Enggmaug/VentilationLignade/Carte Elec/VentilationLignade/VentilationLignade.kicad_pcb

## KiCad design Carte Elec/VentilationLignade/VentilationLignade.kicad_pcb (2017-06-05)

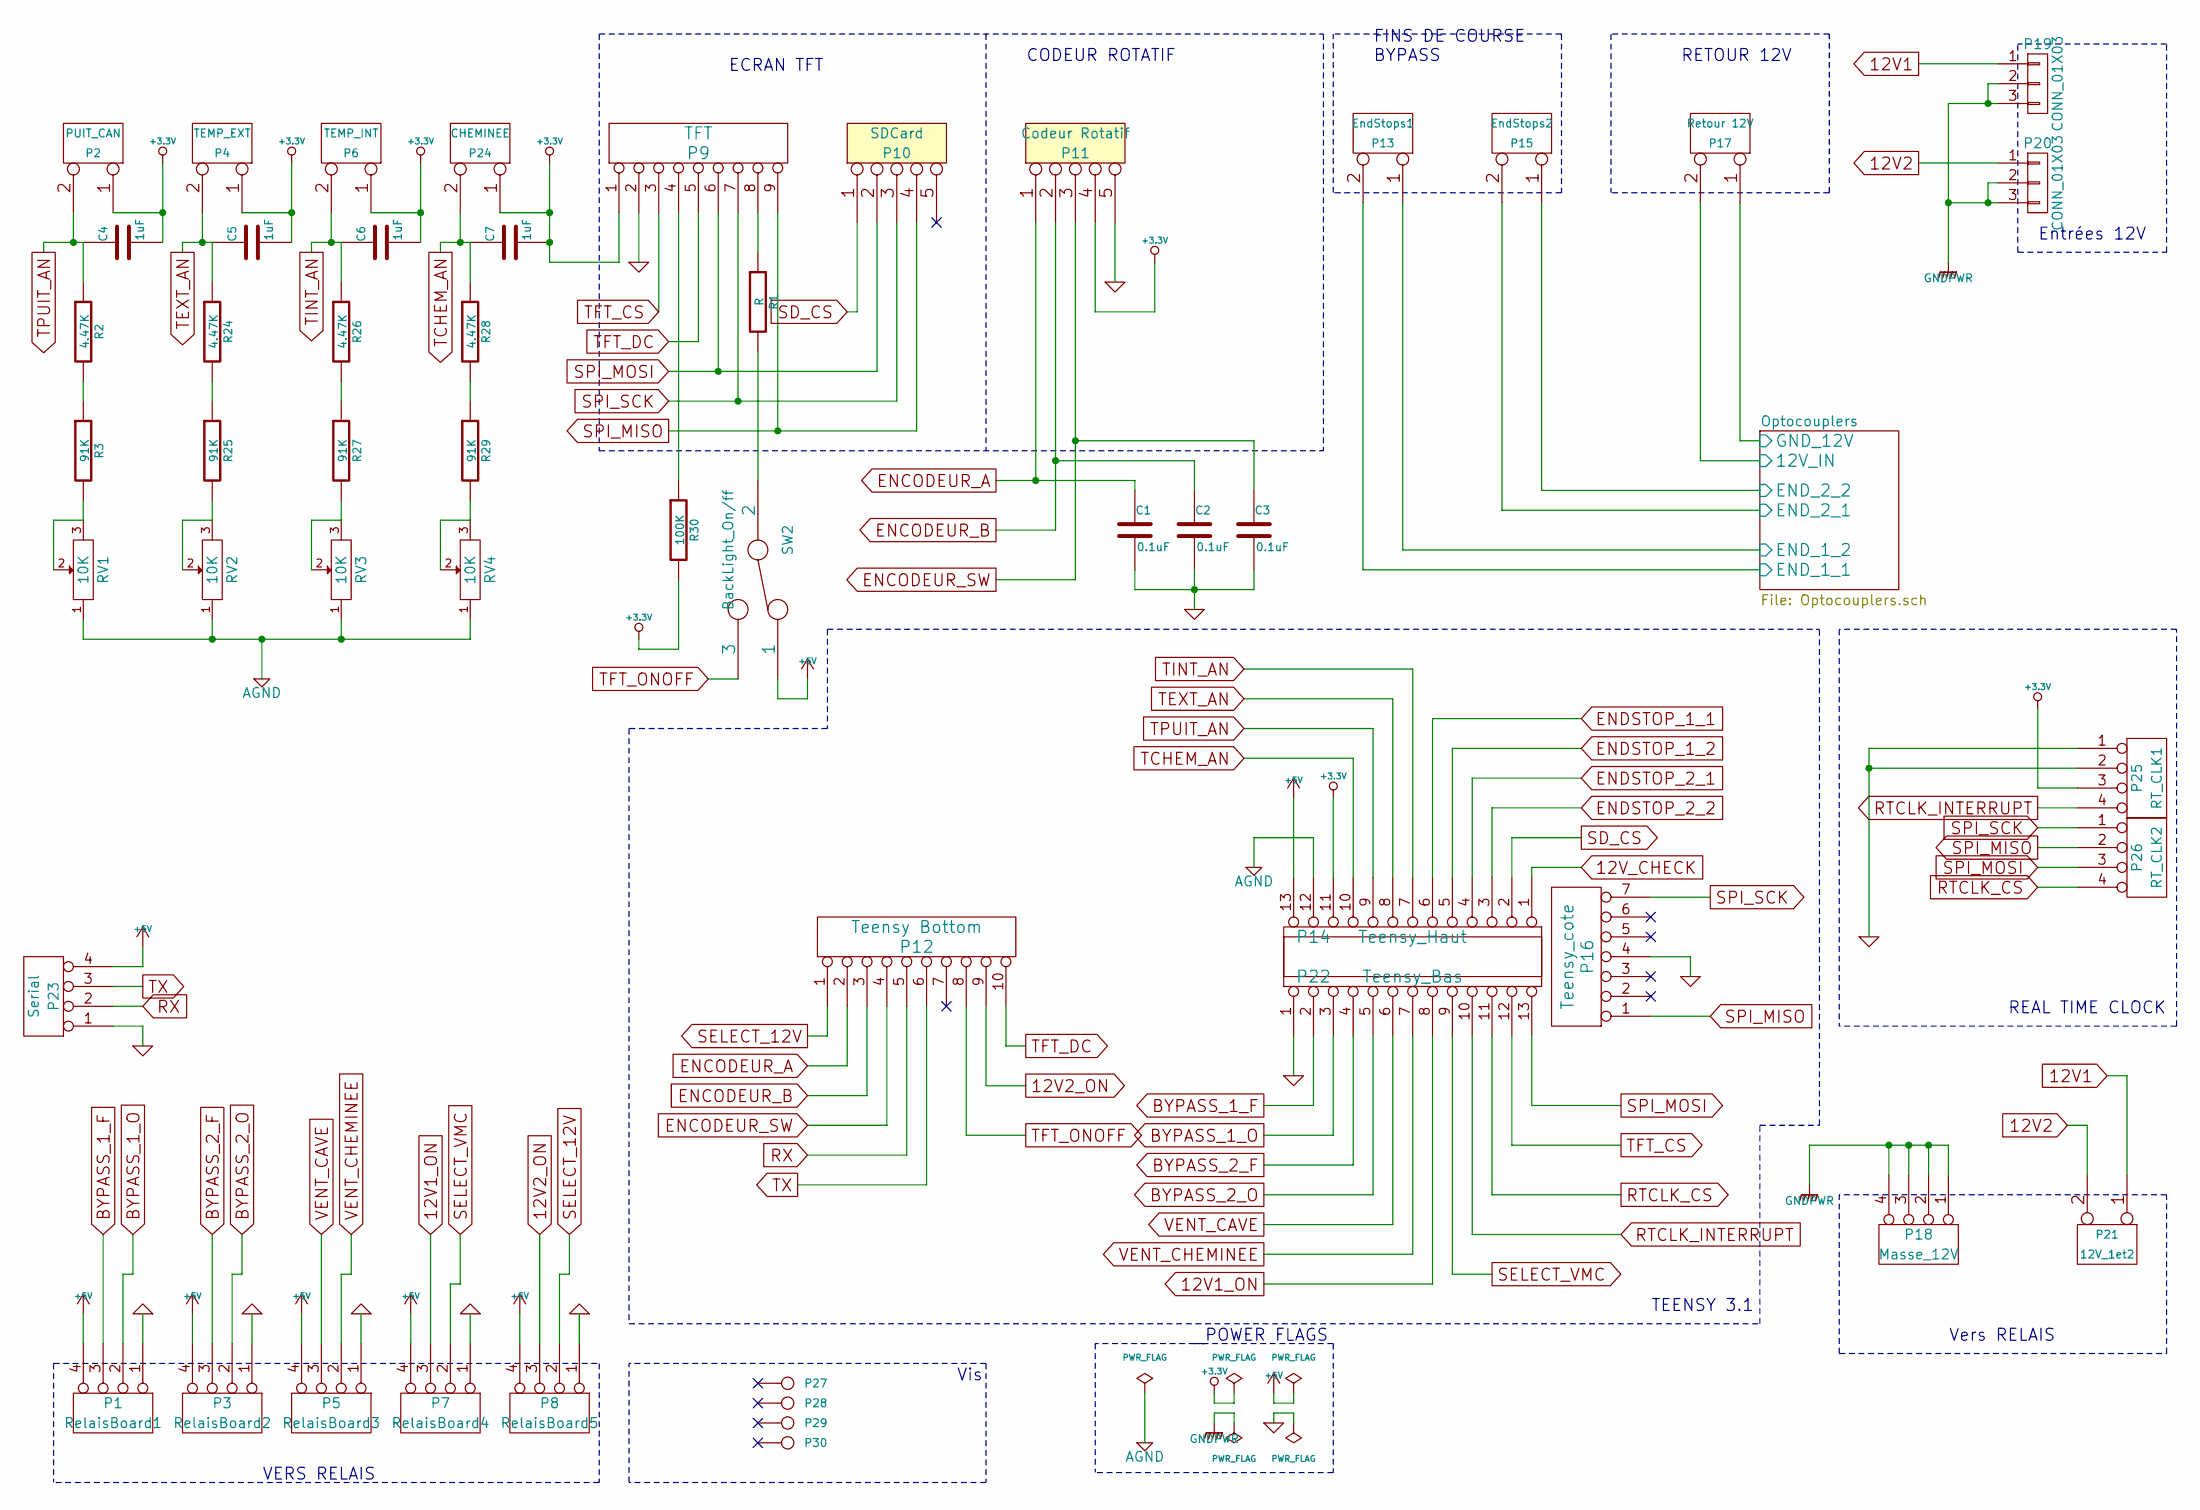
[picture p1: schematic VentilationLignade.sch]

Parts:
C1, C2, C3: 0.1uF; C_Rect_L7_W2.5_P5
C4, C5, C6, C7: 1uF; C_Radial_D8_L11.5_P3.5
P1: RelaisBoard1; Pin_Header_Straight_1x04
P2: PUIT_CAN; bornier2
P3: RelaisBoard2; Pin_Header_Straight_1x04
P4: TEMP_EXT; bornier2
P5: RelaisBoard3; Pin_Header_Straight_1x04
P6: TEMP_INT; bornier2
P7: RelaisBoard4; Pin_Header_Straight_1x04
P8: RelaisBoard5; Pin_Header_Straight_1x04
P9: TFT; Pin_Header_Straight_1x09
P10: SDCard; Pin_Header_Straight_1x05
P11: Codeur Rotatif; Pin_Header_Straight_1x05
P12: Teensy Bottom; Pin_Header_Straight_1x10
P13: EndStops1; bornier2
P14: Teensy_Haut; Pin_Header_Straight_1x13
P15: EndStops2; bornier2
P16: Teensy_cote; Pin_Header_Straight_1x07
P17: Retour 12V; bornier2
P18: Masse_12V; Pin_Header_Straight_1x04
P19, P20: CONN_01X03; Alim
P21: 12V_1et2; bornier2
P22: Teensy_Bas; Pin_Header_Straight_1x13
P23: Serial; Pin_Header_Straight_1x04
P24: CHEMINEE; bornier2
P25: RT_CLK1; Pin_Header_Straight_1x04
P26: RT_CLK2; Pin_Header_Straight_1x04
P27, P28, P29, P30: CONN_1; VIS
R1: R; Resistor_Horizontal_RM15mm
R2, R24, R26, R28: 4.47K; R_1206_HandSoldering
R3, R25, R27, R29: 91K; R_1206_HandSoldering
R30: 100K; R_1206_HandSoldering
RV1, RV2, RV3, RV4: 10K; Potar
SW2: BackLight_On/ff; Pin_Header_Straight_1x03

Connections:
12V1: P19.1, P21.1
12V1_ON: P7.3, P22.8
12V2: P20.1, P21.2 (PM)
12V2_ON: P8.3, P12.9
12V_CHECK: P14.1; also elsewhere on the board
+3.3V: C4.2, C5.2, C6.2, C7.2, P2.1, P4.1, P6.1, P9.1, P11.4, P14.11, P24.1, P25.3, R30.2; also elsewhere on the board
+5V: P1.4, P3.4, P5.4, P7.4, P8.4, P14.13, P23.4, SW2.1
/Optocouplers/12V_IN: P17.2 (PM); also elsewhere on the board
/Optocouplers/END_1_1: P13.2 (PM); also elsewhere on the board
/Optocouplers/END_1_2: P13.1; also elsewhere on the board
/Optocouplers/END_2_1: P15.2 (PM); also elsewhere on the board
/Optocouplers/END_2_2: P15.1; also elsewhere on the board
AGND: P14.12, RV1.1, RV2.1, RV3.1, RV4.1
BYPASS_1_F: P1.3, P22.2
BYPASS_1_O: P1.2, P22.3
BYPASS_2_F: P3.3, P22.4
BYPASS_2_O: P3.2, P22.5
ENCODEUR_A: C1.1, P11.1, P12.2
ENCODEUR_B: C2.1, P11.2, P12.3
ENCODEUR_SW: C3.1, P11.3, P12.4
ENDSTOP_1_1: P14.6; also elsewhere on the board
ENDSTOP_1_2: P14.5; also elsewhere on the board
ENDSTOP_2_1: P14.4; also elsewhere on the board
ENDSTOP_2_2: P14.3; also elsewhere on the board
GND: C1.2, C2.2, C3.2, P1.1, P3.1, P5.1, P7.1, P8.1, P9.2, P11.5, P16.4, P22.1, P23.1, P25.1, P25.2; also elsewhere on the board
GNDPWR: P17.1, P18.1, P18.2, P18.3, P18.4, P19.2, P19.3, P20.2, P20.3; also elsewhere on the board
unnamed: P9.4, R30.1
unnamed: P9.8, R1.1
unnamed: R1.2, SW2.2
unnamed: R2.2, R3.1
unnamed: R3.2, RV1.2, RV1.3
unnamed: R24.2, R25.1
unnamed: R25.2, RV2.2, RV2.3
unnamed: R26.2, R27.1
unnamed: R27.2, RV3.2, RV3.3
unnamed: R28.2, R29.1
unnamed: R29.2, RV4.2, RV4.3
RTCLK_CS: P22.11, P26.4
RTCLK_INTERRUPT: P22.10, P25.4
RX: P12.5, P23.2
SD_CS: P10.1, P14.2
SELECT_12V: P8.2, P12.1
SELECT_VMC: P7.2, P22.9
SPI_MISO: P9.9, P10.4, P16.1, P26.2
SPI_MOSI: P9.6, P10.2, P22.13, P26.3
SPI_SCK: P9.7, P10.3, P16.7, P26.1
TCHEM_AN: C7.1, P14.10, P24.2 (PM), R28.1
TEXT_AN: C5.1, P4.2 (PM), P14.8, R24.1
TFT_CS: P9.3, P22.12
TFT_DC: P9.5, P12.10
TFT_ONOFF: P12.8, SW2.3
TINT_AN: C6.1, P6.2 (PM), P14.7, R26.1
TPUIT_AN: C4.1, P2.2 (PM), P14.9, R2.1
TX: P12.6, P23.3
VENT_CAVE: P5.3, P22.6
VENT_CHEMINEE: P5.2, P22.7

Notes on the sheet:
Vis
VERS RELAIS
Entrées 12V
Vers RELAIS
CODEUR ROTATIF
ECRAN TFT
FINS DE COURSE BYPASS
TEENSY 3.1
RETOUR 12V
POWER FLAGS
REAL TIME CLOCK

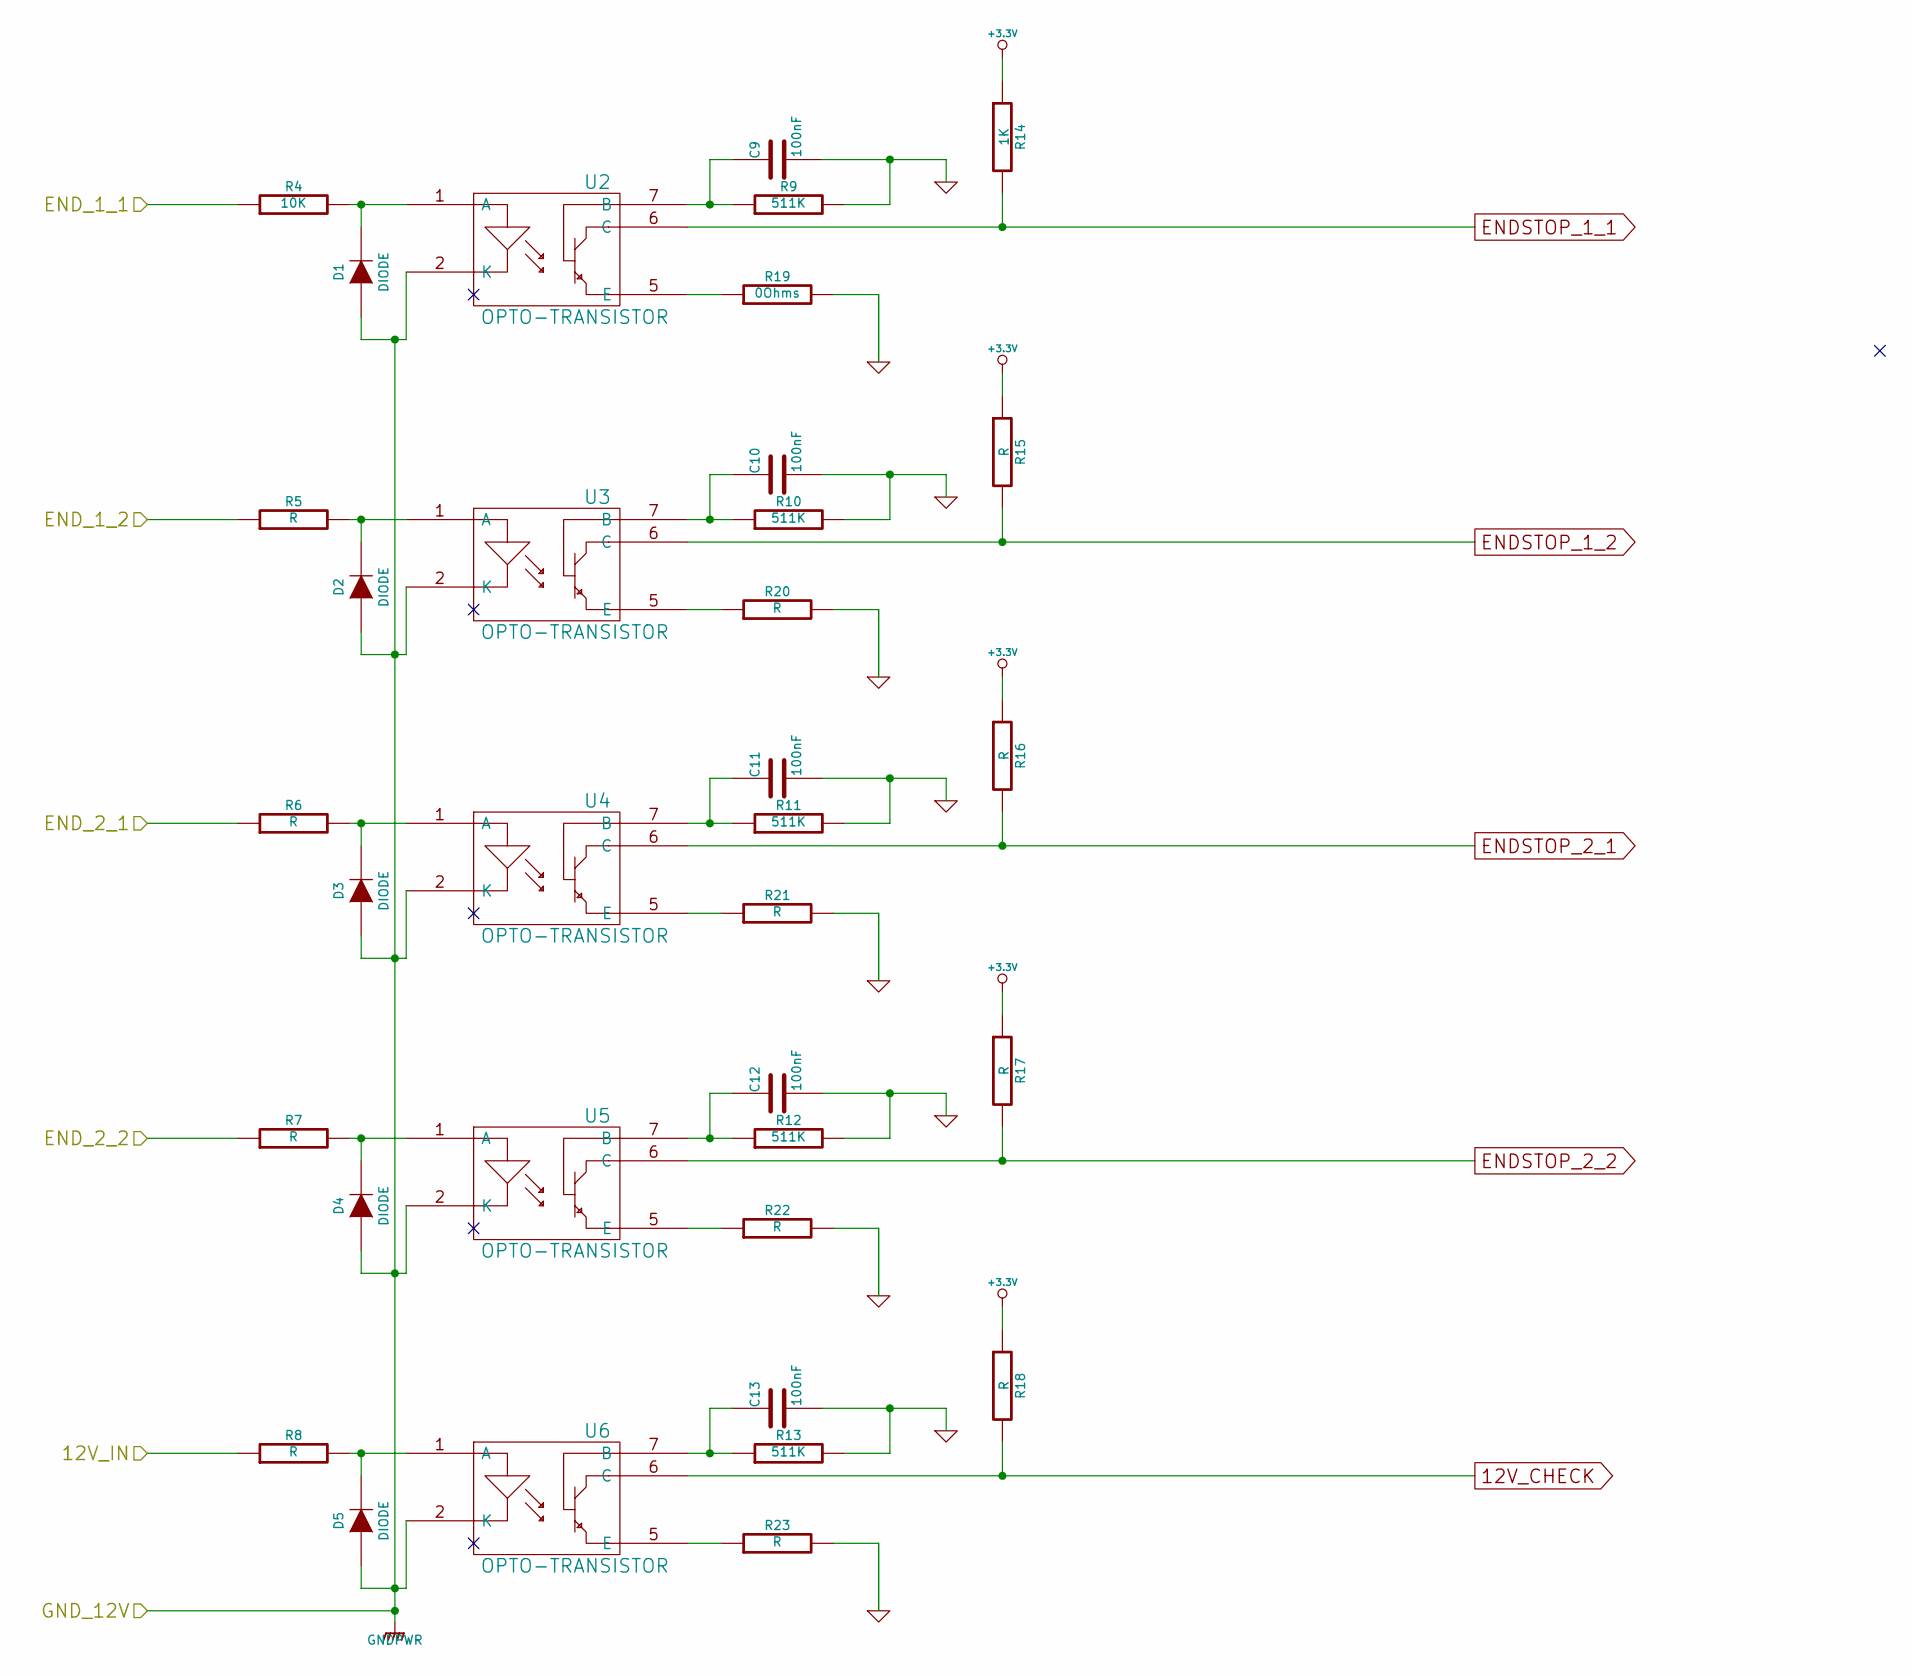
[picture p2: schematic Optocouplers.sch]

Parts:
C9, C10, C11, C12, C13: 100nF; C_0805_HandSoldering
D1, D2, D3, D4, D5: DIODE; SOT-23
R4: 10K; R_1206_HandSoldering
R5, R6, R7, R8, R15, R16, R17, R18, R20, R21, R22, R23: R; R_1206_HandSoldering
R9, R10, R11, R12, R13: 511K; R_1206_HandSoldering
R14: 1K; R_1206_HandSoldering
R19: 0Ohms; R_1206_HandSoldering
U2, U3, U4, U5, U6: OPTO-TRANSISTOR; SOIC-8-N

Connections:
12V_CHECK: R18.2, U6.6 (C); also elsewhere on the board
+3.3V: R14.1, R15.1, R16.1, R17.1, R18.1; also elsewhere on the board
/Optocouplers/12V_IN: R8.1; also elsewhere on the board
/Optocouplers/END_1_1: R4.1; also elsewhere on the board
/Optocouplers/END_1_2: R5.1; also elsewhere on the board
/Optocouplers/END_2_1: R6.1; also elsewhere on the board
/Optocouplers/END_2_2: R7.1; also elsewhere on the board
ENDSTOP_1_1: R14.2, U2.6 (C); also elsewhere on the board
ENDSTOP_1_2: R15.2, U3.6 (C); also elsewhere on the board
ENDSTOP_2_1: R16.2, U4.6 (C); also elsewhere on the board
ENDSTOP_2_2: R17.2, U5.6 (C); also elsewhere on the board
GND: C9.2, C10.2, C11.2, C12.2, C13.2, R9.2, R10.2, R11.2, R12.2, R13.2, R19.2, R20.2, R21.2, R22.2, R23.2; also elsewhere on the board
GNDPWR: D1.1 (A), D2.1 (A), D3.1 (A), D4.1 (A), D5.1 (A), U2.2 (K), U3.2 (K), U4.2 (K), U5.2 (K), U6.2 (K); also elsewhere on the board
unnamed: C9.1, R9.1, U2.7 (B)
unnamed: C10.1, R10.1, U3.7 (B)
unnamed: C11.1, R11.1, U4.7 (B)
unnamed: C12.1, R12.1, U5.7 (B)
unnamed: C13.1, R13.1, U6.7 (B)
unnamed: D1.2 (K), R4.2, U2.1 (A)
unnamed: D2.2 (K), R5.2, U3.1 (A)
unnamed: D3.2 (K), R6.2, U4.1 (A)
unnamed: D4.2 (K), R7.2, U5.1 (A)
unnamed: D5.2 (K), R8.2, U6.1 (A)
unnamed: R19.1, U2.5 (E)
unnamed: R20.1, U3.5 (E)
unnamed: R21.1, U4.5 (E)
unnamed: R22.1, U5.5 (E)
unnamed: R23.1, U6.5 (E)

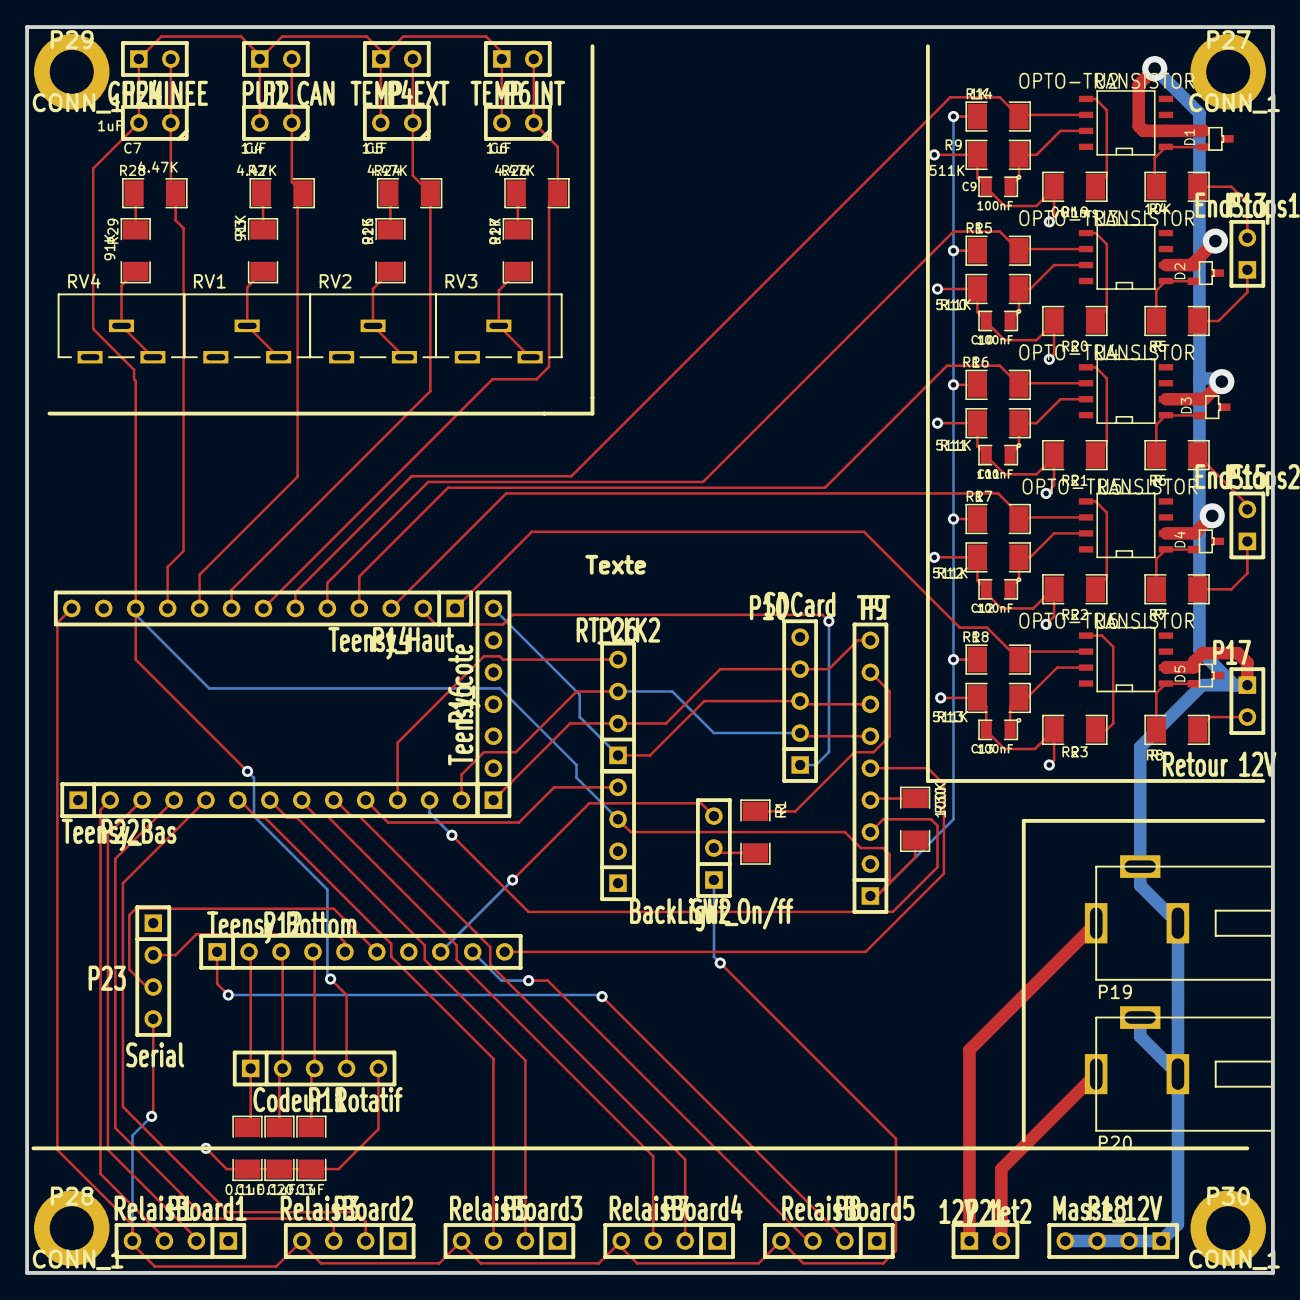
[picture p3: board VentilationLignade.kicad_pcb from above]

Board: 2 copper layers, 99.1 x 99.1 mm, 86 parts (0 on the bottom side), 70 nets.
