Enggmaug/VentilationLignade/Carte Elec/VentilationLignade/Optocouplers.sch

## KiCad design Carte Elec/VentilationLignade/Optocouplers.sch (2017-06-05)


Parts:
C9, C10, C11, C12, C13: 100nF; C_0805_HandSoldering
D1, D2, D3, D4, D5: DIODE; SOT-23
R4: 10K; R_1206_HandSoldering
R5, R6, R7, R8, R15, R16, R17, R18, R20, R21, R22, R23: R; R_1206_HandSoldering
R9, R10, R11, R12, R13: 511K; R_1206_HandSoldering
R14: 1K; R_1206_HandSoldering
R19: 0Ohms; R_1206_HandSoldering
U2, U3, U4, U5, U6: OPTO-TRANSISTOR; SOIC-8-N

Connections:
12V_CHECK: R18.2, U6.6 (C)
12V_IN: R8.1
+3.3V: R14.1, R15.1, R16.1, R17.1, R18.1
ENDSTOP_1_1: R14.2, U2.6 (C)
ENDSTOP_1_2: R15.2, U3.6 (C)
ENDSTOP_2_1: R16.2, U4.6 (C)
ENDSTOP_2_2: R17.2, U5.6 (C)
END_1_1: R4.1
END_1_2: R5.1
END_2_1: R6.1
END_2_2: R7.1
GND: C9.2, C10.2, C11.2, C12.2, C13.2, R9.2, R10.2, R11.2, R12.2, R13.2, R19.2, R20.2, R21.2, R22.2, R23.2
GNDPWR: D1.1 (A), D2.1 (A), D3.1 (A), D4.1 (A), D5.1 (A), U2.2 (K), U3.2 (K), U4.2 (K), U5.2 (K), U6.2 (K)
unnamed: C9.1, R9.1, U2.7 (B)
unnamed: C10.1, R10.1, U3.7 (B)
unnamed: C11.1, R11.1, U4.7 (B)
unnamed: C12.1, R12.1, U5.7 (B)
unnamed: C13.1, R13.1, U6.7 (B)
unnamed: D1.2 (K), R4.2, U2.1 (A)
unnamed: D2.2 (K), R5.2, U3.1 (A)
unnamed: D3.2 (K), R6.2, U4.1 (A)
unnamed: D4.2 (K), R7.2, U5.1 (A)
unnamed: D5.2 (K), R8.2, U6.1 (A)
unnamed: R19.1, U2.5 (E)
unnamed: R20.1, U3.5 (E)
unnamed: R21.1, U4.5 (E)
unnamed: R22.1, U5.5 (E)
unnamed: R23.1, U6.5 (E)
