Enggmaug/VentilationLignade/Carte Elec/VentilationLignade/VentilationLignade.sch

## KiCad design Carte Elec/VentilationLignade/VentilationLignade.sch (2017-06-05)


Parts:
C1, C2, C3: 0.1uF; C_Rect_L7_W2.5_P5
C4, C5, C6, C7: 1uF; C_Radial_D8_L11.5_P3.5
P1: RelaisBoard1; Pin_Header_Straight_1x04
P2: PUIT_CAN; bornier2
P3: RelaisBoard2; Pin_Header_Straight_1x04
P4: TEMP_EXT; bornier2
P5: RelaisBoard3; Pin_Header_Straight_1x04
P6: TEMP_INT; bornier2
P7: RelaisBoard4; Pin_Header_Straight_1x04
P8: RelaisBoard5; Pin_Header_Straight_1x04
P9: TFT; Pin_Header_Straight_1x09
P10: SDCard; Pin_Header_Straight_1x05
P11: Codeur Rotatif; Pin_Header_Straight_1x05
P12: Teensy Bottom; Pin_Header_Straight_1x10
P13: EndStops1; bornier2
P14: Teensy_Haut; Pin_Header_Straight_1x13
P15: EndStops2; bornier2
P16: Teensy_cote; Pin_Header_Straight_1x07
P17: Retour 12V; bornier2
P18: Masse_12V; Pin_Header_Straight_1x04
P19, P20: CONN_01X03; Alim
P21: 12V_1et2; bornier2
P22: Teensy_Bas; Pin_Header_Straight_1x13
P23: Serial; Pin_Header_Straight_1x04
P24: CHEMINEE; bornier2
P25: RT_CLK1; Pin_Header_Straight_1x04
P26: RT_CLK2; Pin_Header_Straight_1x04
P27, P28, P29, P30: CONN_1; VIS
R1: R; Resistor_Horizontal_RM15mm
R2, R24, R26, R28: 4.47K; R_1206_HandSoldering
R3, R25, R27, R29: 91K; R_1206_HandSoldering
R30: 100K; R_1206_HandSoldering
RV1, RV2, RV3, RV4: 10K; Potar
SW2: BackLight_On/ff; Pin_Header_Straight_1x03

Connections:
12V1: P19.1, P21.1
12V1_ON: P7.3, P22.8
12V2: P20.1, P21.2 (PM)
12V2_ON: P8.3, P12.9
12V_CHECK: P14.1
12V_IN: P17.2 (PM)
+3.3V: C4.2, C5.2, C6.2, C7.2, P2.1, P4.1, P6.1, P9.1, P11.4, P14.11, P24.1, P25.3, R30.2
+5V: P1.4, P3.4, P5.4, P7.4, P8.4, P14.13, P23.4, SW2.1
AGND: P14.12, RV1.1, RV2.1, RV3.1, RV4.1
BYPASS_1_F: P1.3, P22.2
BYPASS_1_O: P1.2, P22.3
BYPASS_2_F: P3.3, P22.4
BYPASS_2_O: P3.2, P22.5
ENCODEUR_A: C1.1, P11.1, P12.2
ENCODEUR_B: C2.1, P11.2, P12.3
ENCODEUR_SW: C3.1, P11.3, P12.4
ENDSTOP_1_1: P14.6
ENDSTOP_1_2: P14.5
ENDSTOP_2_1: P14.4
ENDSTOP_2_2: P14.3
END_1_1: P13.2 (PM)
END_1_2: P13.1
END_2_1: P15.2 (PM)
END_2_2: P15.1
GND: C1.2, C2.2, C3.2, P1.1, P3.1, P5.1, P7.1, P8.1, P9.2, P11.5, P16.4, P22.1, P23.1, P25.1, P25.2
GNDPWR: P18.1, P18.2, P18.3, P18.4, P19.2, P19.3, P20.2, P20.3
GND_12V: P17.1
unnamed: P9.4, R30.1
unnamed: P9.8, R1.1
unnamed: R1.2, SW2.2
unnamed: R2.2, R3.1
unnamed: R3.2, RV1.2, RV1.3
unnamed: R24.2, R25.1
unnamed: R25.2, RV2.2, RV2.3
unnamed: R26.2, R27.1
unnamed: R27.2, RV3.2, RV3.3
unnamed: R28.2, R29.1
unnamed: R29.2, RV4.2, RV4.3
RTCLK_CS: P22.11, P26.4
RTCLK_INTERRUPT: P22.10, P25.4
RX: P12.5, P23.2
SD_CS: P10.1, P14.2
SELECT_12V: P8.2, P12.1
SELECT_VMC: P7.2, P22.9
SPI_MISO: P9.9, P10.4, P16.1, P26.2
SPI_MOSI: P9.6, P10.2, P22.13, P26.3
SPI_SCK: P9.7, P10.3, P16.7, P26.1
TCHEM_AN: C7.1, P14.10, P24.2 (PM), R28.1
TEXT_AN: C5.1, P4.2 (PM), P14.8, R24.1
TFT_CS: P9.3, P22.12
TFT_DC: P9.5, P12.10
TFT_ONOFF: P12.8, SW2.3
TINT_AN: C6.1, P6.2 (PM), P14.7, R26.1
TPUIT_AN: C4.1, P2.2 (PM), P14.9, R2.1
TX: P12.6, P23.3
VENT_CAVE: P5.3, P22.6
VENT_CHEMINEE: P5.2, P22.7

Notes on the sheet:
Vis
VERS RELAIS
Entrées 12V
Vers RELAIS
CODEUR ROTATIF
ECRAN TFT
FINS DE COURSE BYPASS
TEENSY 3.1
RETOUR 12V
POWER FLAGS
REAL TIME CLOCK
