Enggmaug/VentilationLignade/Thermistor.h

typedef struct ThermistorEntry{
  unsigned int Reading;
  float Temperature;
} ThermistorEntry;

const ThermistorEntry ThermistorTable[] = 
{
{999, -39.44},
{997, -38.33},
{994, -37.22},
{992, -36.11},
{990, -35.00},
{987, -33.89},
{985, -32.78},
{982, -31.67},
{979, -30.56},
{975, -29.44},
{972, -28.33},
{968, -27.22},
{964, -26.11},
{960, -25.00},
{956, -23.89},
{952, -22.78},
{947, -21.67},
{942, -20.56},
{936, -19.44},
{931, -18.33},
{925, -17.22},
{919, -16.11},
{913, -15.00},
{906, -13.89},
{899, -12.78},
{892, -11.67},
{884, -10.56},
{876, -9.44 },
{868, -8.33 },
{860, -7.22 },
{851, -6.11 },
{842, -5.00 },
{832, -3.89 },
{823, -2.78 },
{813, -1.67 },
{802, -0.56 },
{792, 0.56  },
{781, 1.67  },
{770, 2.78  },
{758, 3.89  },
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
