Enggmaug/VentilationLignade/(commit log)

2015-08-16 Ajout des fichiers courants
2015-08-18 Definition des transitions de la machine d'etat. Ecriture de la trame de fond.
2015-08-18 Ajout du fichier excel de définition
    [Diagramme d'états.xls]
2015-08-18 Nettoyage, sortie de la selection VMC des ventilos
    [Diagramme d'états.xls]
2015-08-18 Ajout Mode Maintenance, Codage de la machine d'états
2015-08-18 Debug des define des endstops.
2015-08-21 Version Opérationelle 1.0
    [Diagramme d'états.xls]
2015-08-21 Affichage des commandes envoyées par Serie.
2015-08-21 Amelioration des messages de debug
2015-08-21 Ajout Excel Branchements
    [Branchements.xlsx]
2015-08-21 Correction Bug : Eteindre l'alim en fin de Bypass2
    [lignade.h]
2015-08-21 Changement des pins pour V12 nb 2
    [Branchements.xlsx]
2015-08-23 Debug en place - Attention Pb d'initialisation
    [Diagramme d'états.xls]
2015-08-23 Reprise totale de la structure de code
2015-08-23 Corrections sur cible. Programme fonctionnel en mode MAINTENANCE
    [VentilationLignade.ino, lignade.h]
2015-08-24 Changement des valeurs d'états. La machine d'états est retirée de la documentation, car obsolete vis à vis du code.
    [Diagramme d'états.xls, Valeurs de Transition.xls]
2015-08-24 Mise à jour des branchements.
    [Branchements.xlsx]
2015-09-02 reaffectation des Pins pour mettre en place écran et SDCard en SPI.
    Puisqu'il manque des IOs, on prévoit un controleur d'IO en I2C.
2015-09-02 Ajout de commentaires
2015-09-02 Ajout d'un affichage de test sur écran TFT
2015-09-02 Ajout des différents écrans à afficher.
    [Ecrans.xlsx]
2015-09-02 Implementation en cours de l'ecran.
    [Ecrans.xlsx]
2015-09-02 Ecran Fonctionnel sur Teensy 3.1 - a essayer sur Teensy LC
2015-09-05 Ajout d'écrans faits sur Photoshop. Décrivent les entrées seulement. Les sorties doivent rester en mode texte pour le moment (compliqué de représenter les VMCs)
2015-09-05 1er Essai bof bof : Probleme l'affichage est super lent, et la SD card n'est pas reconnue.
    [VentilationLignade.ino, lignade.h]
2015-09-05 Intégration des écrans BMP sur lecture carte SD.
2015-09-06 Separation en fichiers pour chaque partie, et ajout de thilam pour le message d'attente
2015-09-06 Reprise complete du Pinning pour etre capable d'accepter un encodeur en plus, et en utilisant un Teensy 3.1 au lieu de LC.
2015-09-06 Ajout du projet KiCad pour Imprimer une carte qui va bien.
    [Optocouplers.sch, VentilationLignade.sch]
2015-09-06 Ajout Netliste creation Board
    [VentilationLignade.kicad_pcb, VentilationLignade.sch]
2015-09-07 Dessin de carte. Changement des pins pour avoir un truc cohérent au niveau de la carte.
    [Optocouplers.sch, VentilationLignade.kicad_pcb, VentilationLignade.sch]
2015-09-08 Ajout d'un RS232 MAX au cas ou.
    [Optocouplers.sch, VentilationLignade.kicad_pcb, VentilationLignade.sch]
2015-09-09 Reprise de la carte => Dimensions réduites 50x100mm
    [Optocouplers.sch, VentilationLignade.kicad_pcb, VentilationLignade.sch]
2015-09-13 Reprise de carte : Suppression MAX232, pour avoir la place de mettre les MOC207
    [Optocouplers.sch, VentilationLignade.kicad_pcb, VentilationLignade.sch]
2015-09-13 Changement taille 100x160 (pour fab maison)
    [Optocouplers.sch, VentilationLignade.kicad_pcb, VentilationLignade.sch]
2015-09-14 Traceage Poscript
    [VentilationLignade.kicad_pcb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]
2015-09-15 Agrandissement des pads de connecteur, pour pouvoir percer et souder sans soucis.
    [VentilationLignade.kicad_pcb]
2015-09-15 Eloignement des pistes proches
    [VentilationLignade.kicad_pcb]
2015-09-16 Renommage des Températures
2015-10-02 Modification carte pour utiliser thermistors et real time clock.
    [Optocouplers.sch, VentilationLignade.kicad_pcb, VentilationLignade.sch]
2015-10-04 Correction des zones sur le dessus.
    [VentilationLignade.kicad_pcb]
2015-10-08 Ajout des placements de perçages sur les pastilles
2015-11-12 Modif pour ouvrir sur Kicad last version
    [VentilationLignade.kicad_pcb]
2015-11-13 Changement des boitiers en cours de reroutage
    [Optocouplers.sch, VentilationLignade.kicad_pcb, VentilationLignade.sch]
2015-11-13 Ajout de l alib rescue (cree lors du passage a la derniere version de kicad ?)
2015-11-14 Ajout de valeur de composants
    [Optocouplers.sch]
2015-11-17 Ajout des modèles 3D
2016-07-17 Réintégration du projet "TestMenu"
    [Ecrans.xlsx, Optocouplers.sch, Valeurs de Transition.xls]
2016-07-25 Changement de pin suite a soudure
2016-07-27 Ajout de la lecture des températures - part 1
2016-07-27 Ajout de la lecture des températures - part 2 - ok
2016-07-27 Incrementation du compteur de moyenne floatante sur les températures
2016-07-27 Ajout de la détection de changement d'état d'entrée
2016-07-27 Le seuil de température extérieure basse n'est pas réglable : il s'agit de la température du puit Canandien. Les seuils et hysteresis du PC ne sont pas réglables : aucune sortie ne lui est lié.
2016-07-27 Début de la mise en place des sorties
    [Valeurs de Transition.xls]
2016-07-28 Implementation des gestion de sorties + ecran associé
2016-07-28 Ajout de la gestion du Debug : On peut modifier la température à la main.
2016-07-28 Si on quitte le mode debug, on reprend les températures réelles.
2016-07-30 Ajout du fichier de gestion des sorties, et corrections liées au menu de maintenance.
    [GestionSorties.ino, GestionTemperatures.ino, Loop.ino, Navigation.ino, VentilationLignade.ino]
2016-07-30 Correction de Bugs Maintenance
    [Actions.ino, DisplayScreen.ino, Loop.ino, Navigation.ino, Setup.ino, VentilationLignade.ino]
2016-08-28 Indication de la suppression de seuil TExt Basse dans le fichier xls
    [Valeurs de Transition.xls]
2016-08-28 Reorder des temperatures
2017-04-06 Carte a reprendre
    [Optocouplers.sch, VentilationLignade.brd, VentilationLignade.sch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]
2017-04-09 Modif de la carte => Commande SEEED !!!
    [Optocouplers.sch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]
2017-06-05 Modif elec et dossier de commande carte
    [Optocouplers.sch, Thermistor.xlsx, VentilationLignade.kicad_pcb, VentilationLignade.sch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]
2017-06-25 Premières modifs pour faire tourner la carte Imprimée Seeed
2023-08-12 Home Assistant : ESP Home
    [Valeurs de Transition.xls]
